josephwinkler/MLCC_Stacking_Practical_Guide/20251010_MLCC_Stacking_PCB_Stencil_v2.pdf

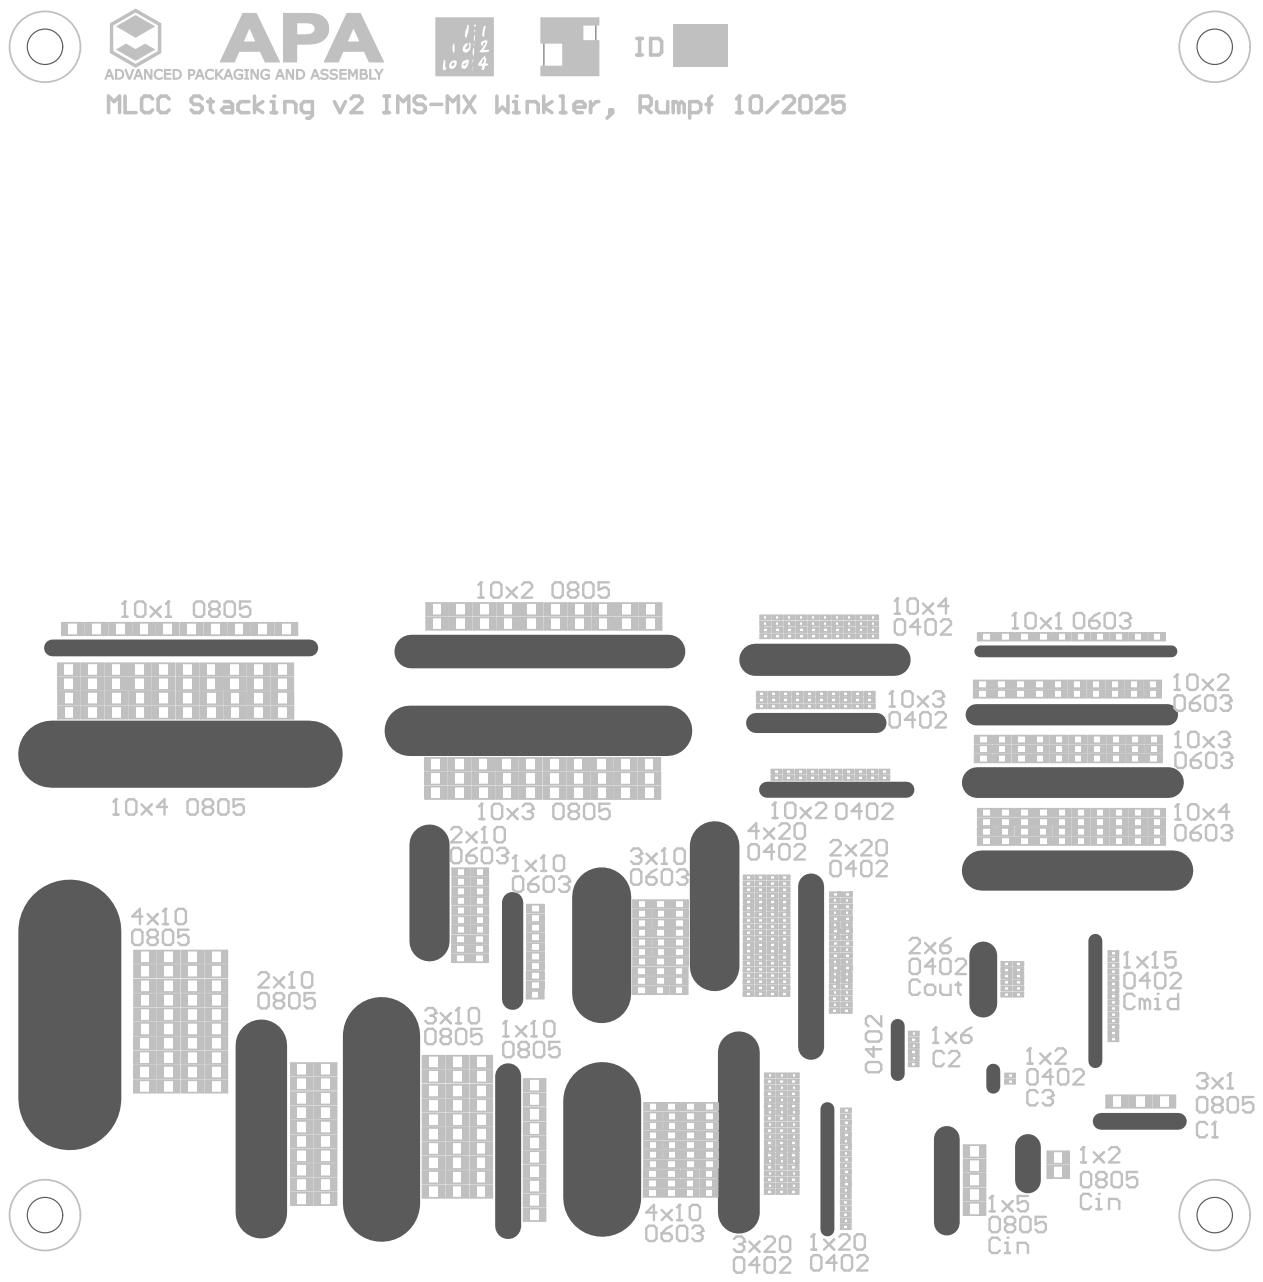
[picture p1: page 1]
