josephwinkler/MLCC_Stacking_Practical_Guide/(list of files, drawings)

Other design files:
20251010_MLCC_Stacking_PCB_Stencil_v2.PcbDoc
